gztproject/NixieClock/PCB/NixieClock2.png

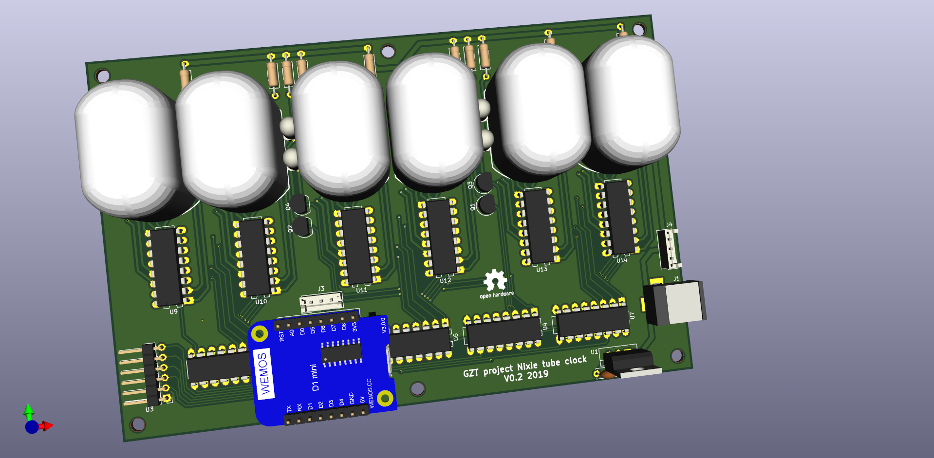
PCB/NixieClock2.png
