gztproject/NixieClock/README.md

# NixieClock

* Install VS Code
  * Install PlatformIO
* Clone/download this repo
* Open with VS Code/PlatformIO
* Copy config_override_example.h to config_override.h
  * Edit settings in config_override.h
* Build and upload to your ESP8266
