gztproject/NixieClock/PCB/NixieClock.png

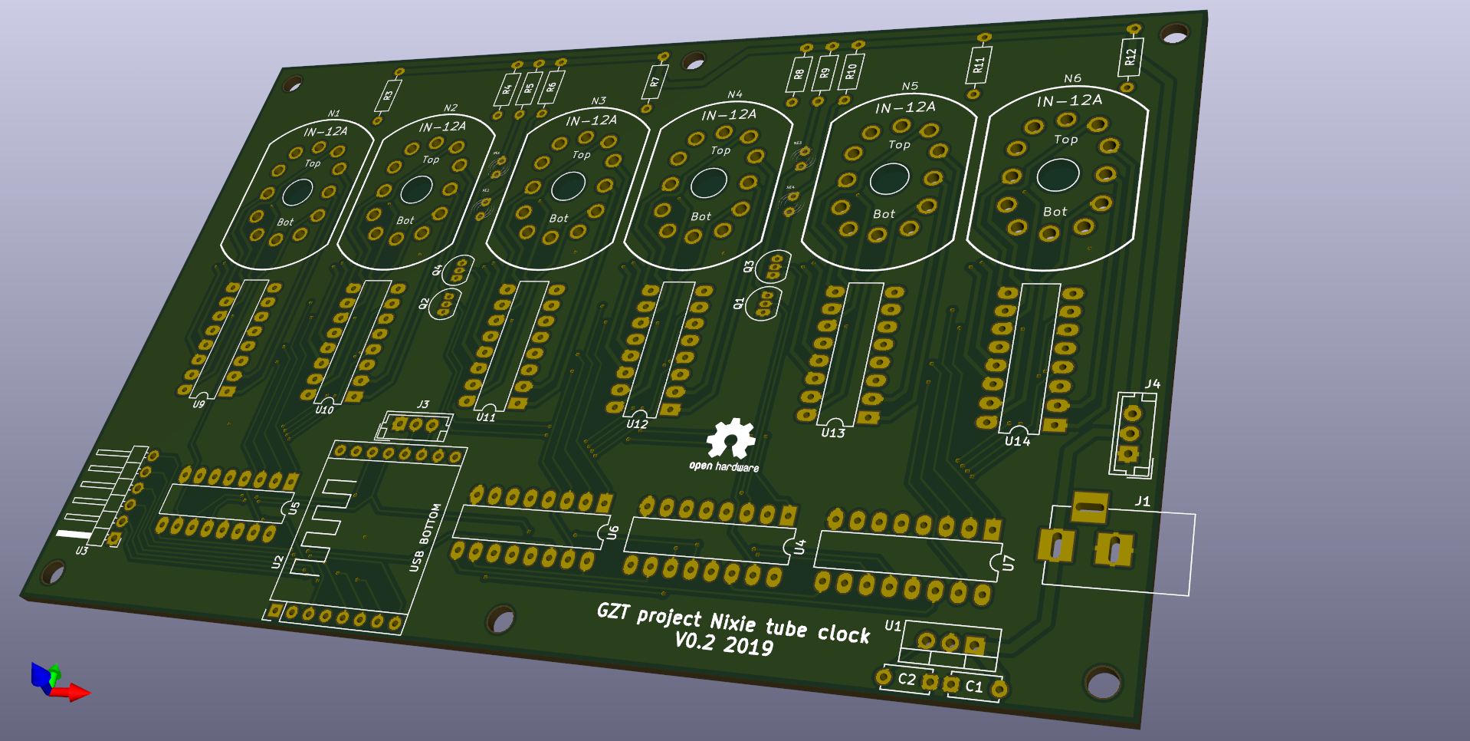
PCB/NixieClock.png
