gztproject/NixieClock/PCB/NixieClock.pdf

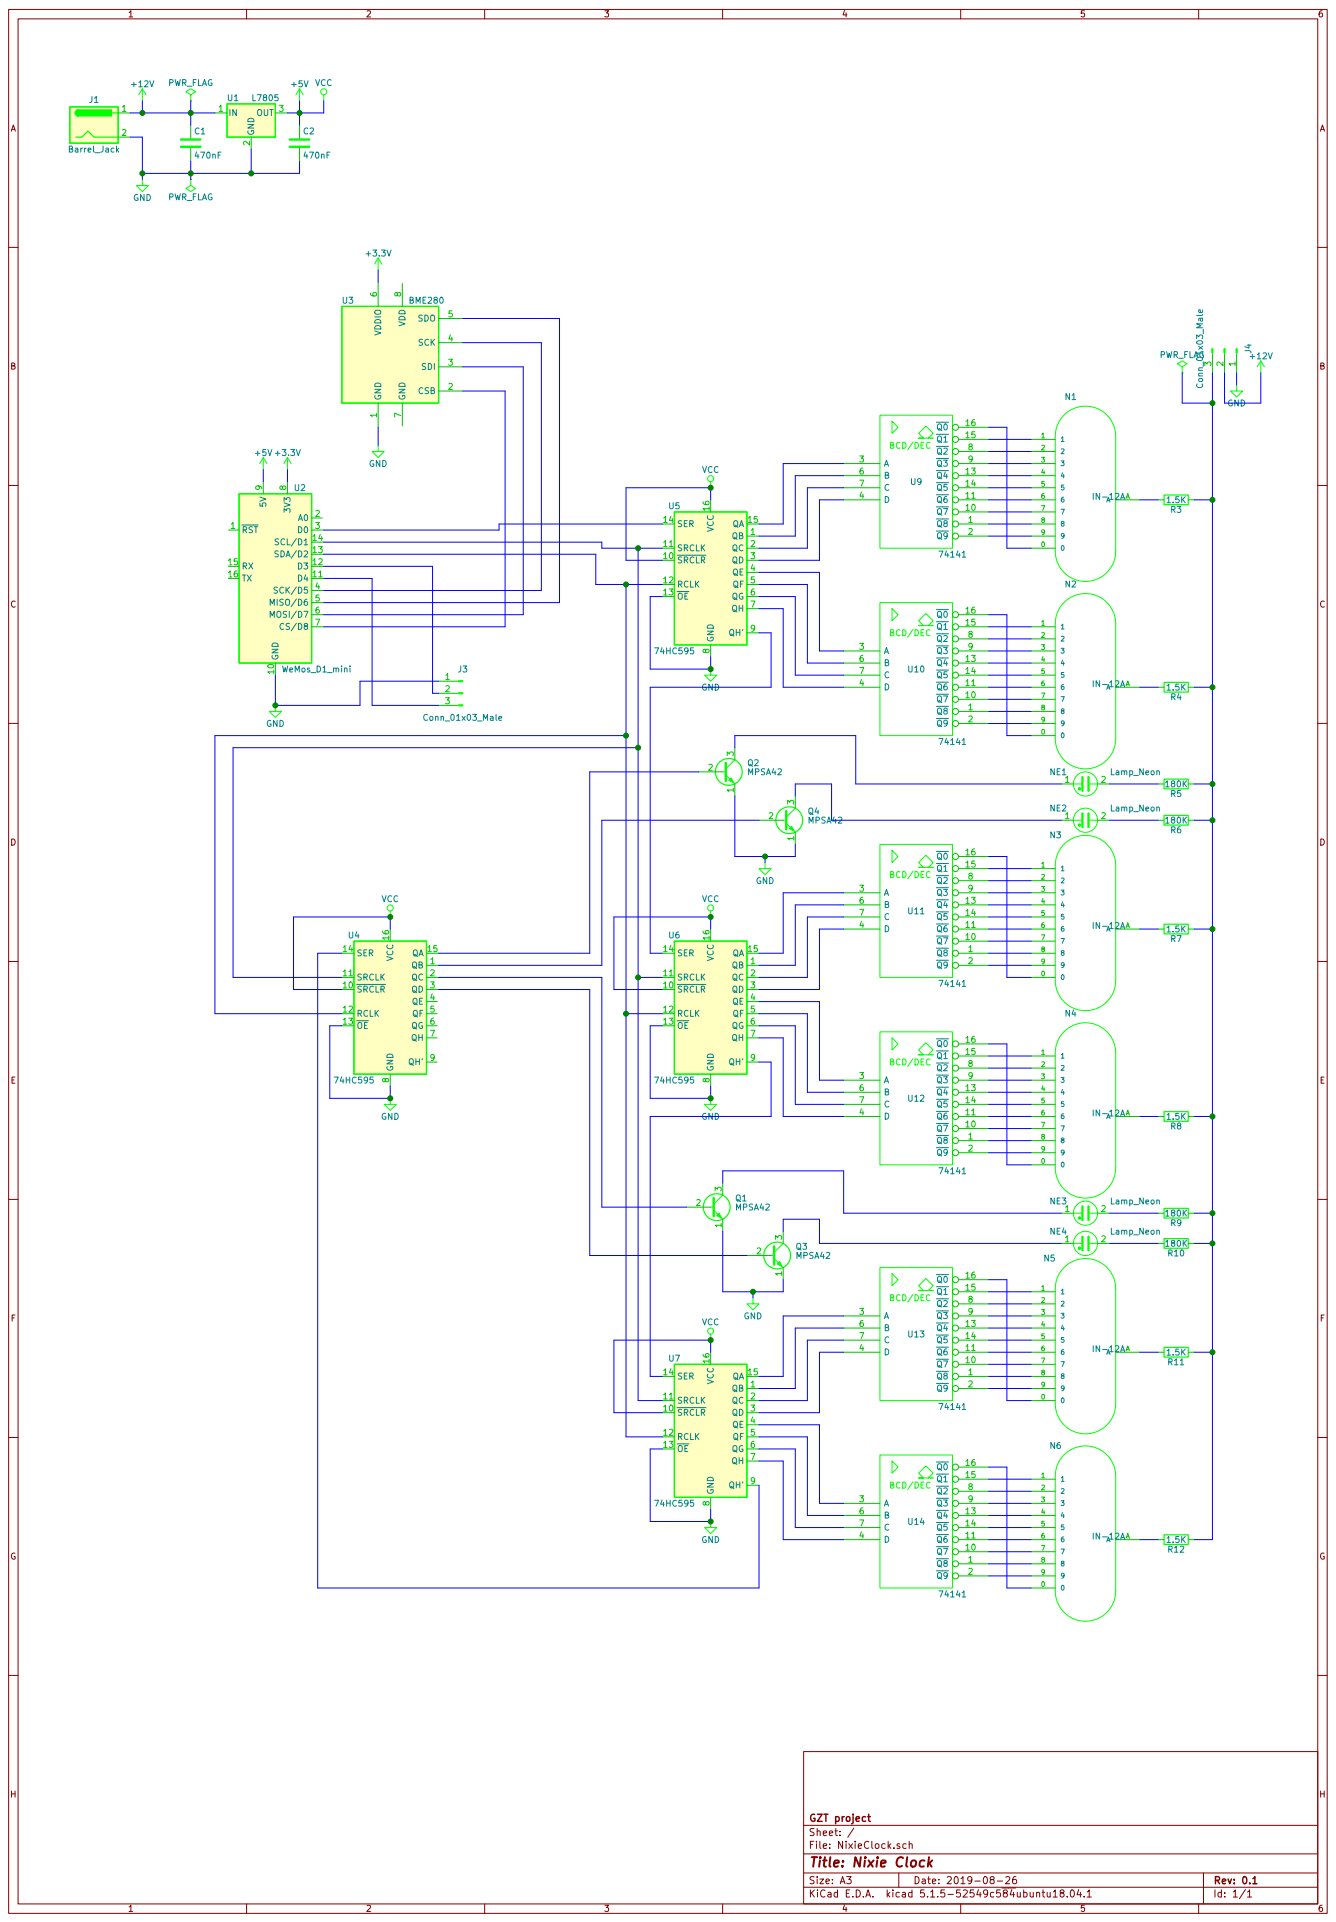
[picture p3: page 1]

1 CSB 2 SDI 3 SCK 4 SDO 5 VDDIO

3 Q2 MPSA42 VCC GND QB 1 SRCLR 10 SRCLK 11 RCLK 12 OE 13 SER 14 QA 15 VCC 16 QC 2 QD 3 QE 4 QF 5 QG 6 QH 7 GND

File: NixieClock.sch Sheet: / GZT project

Id: 1/1 Title: Nixie Clock
