gztproject/NixieClock/PCB/NixieClock.kicad_pcb

## KiCad design PCB/NixieClock.kicad_pcb (2022-11-04)

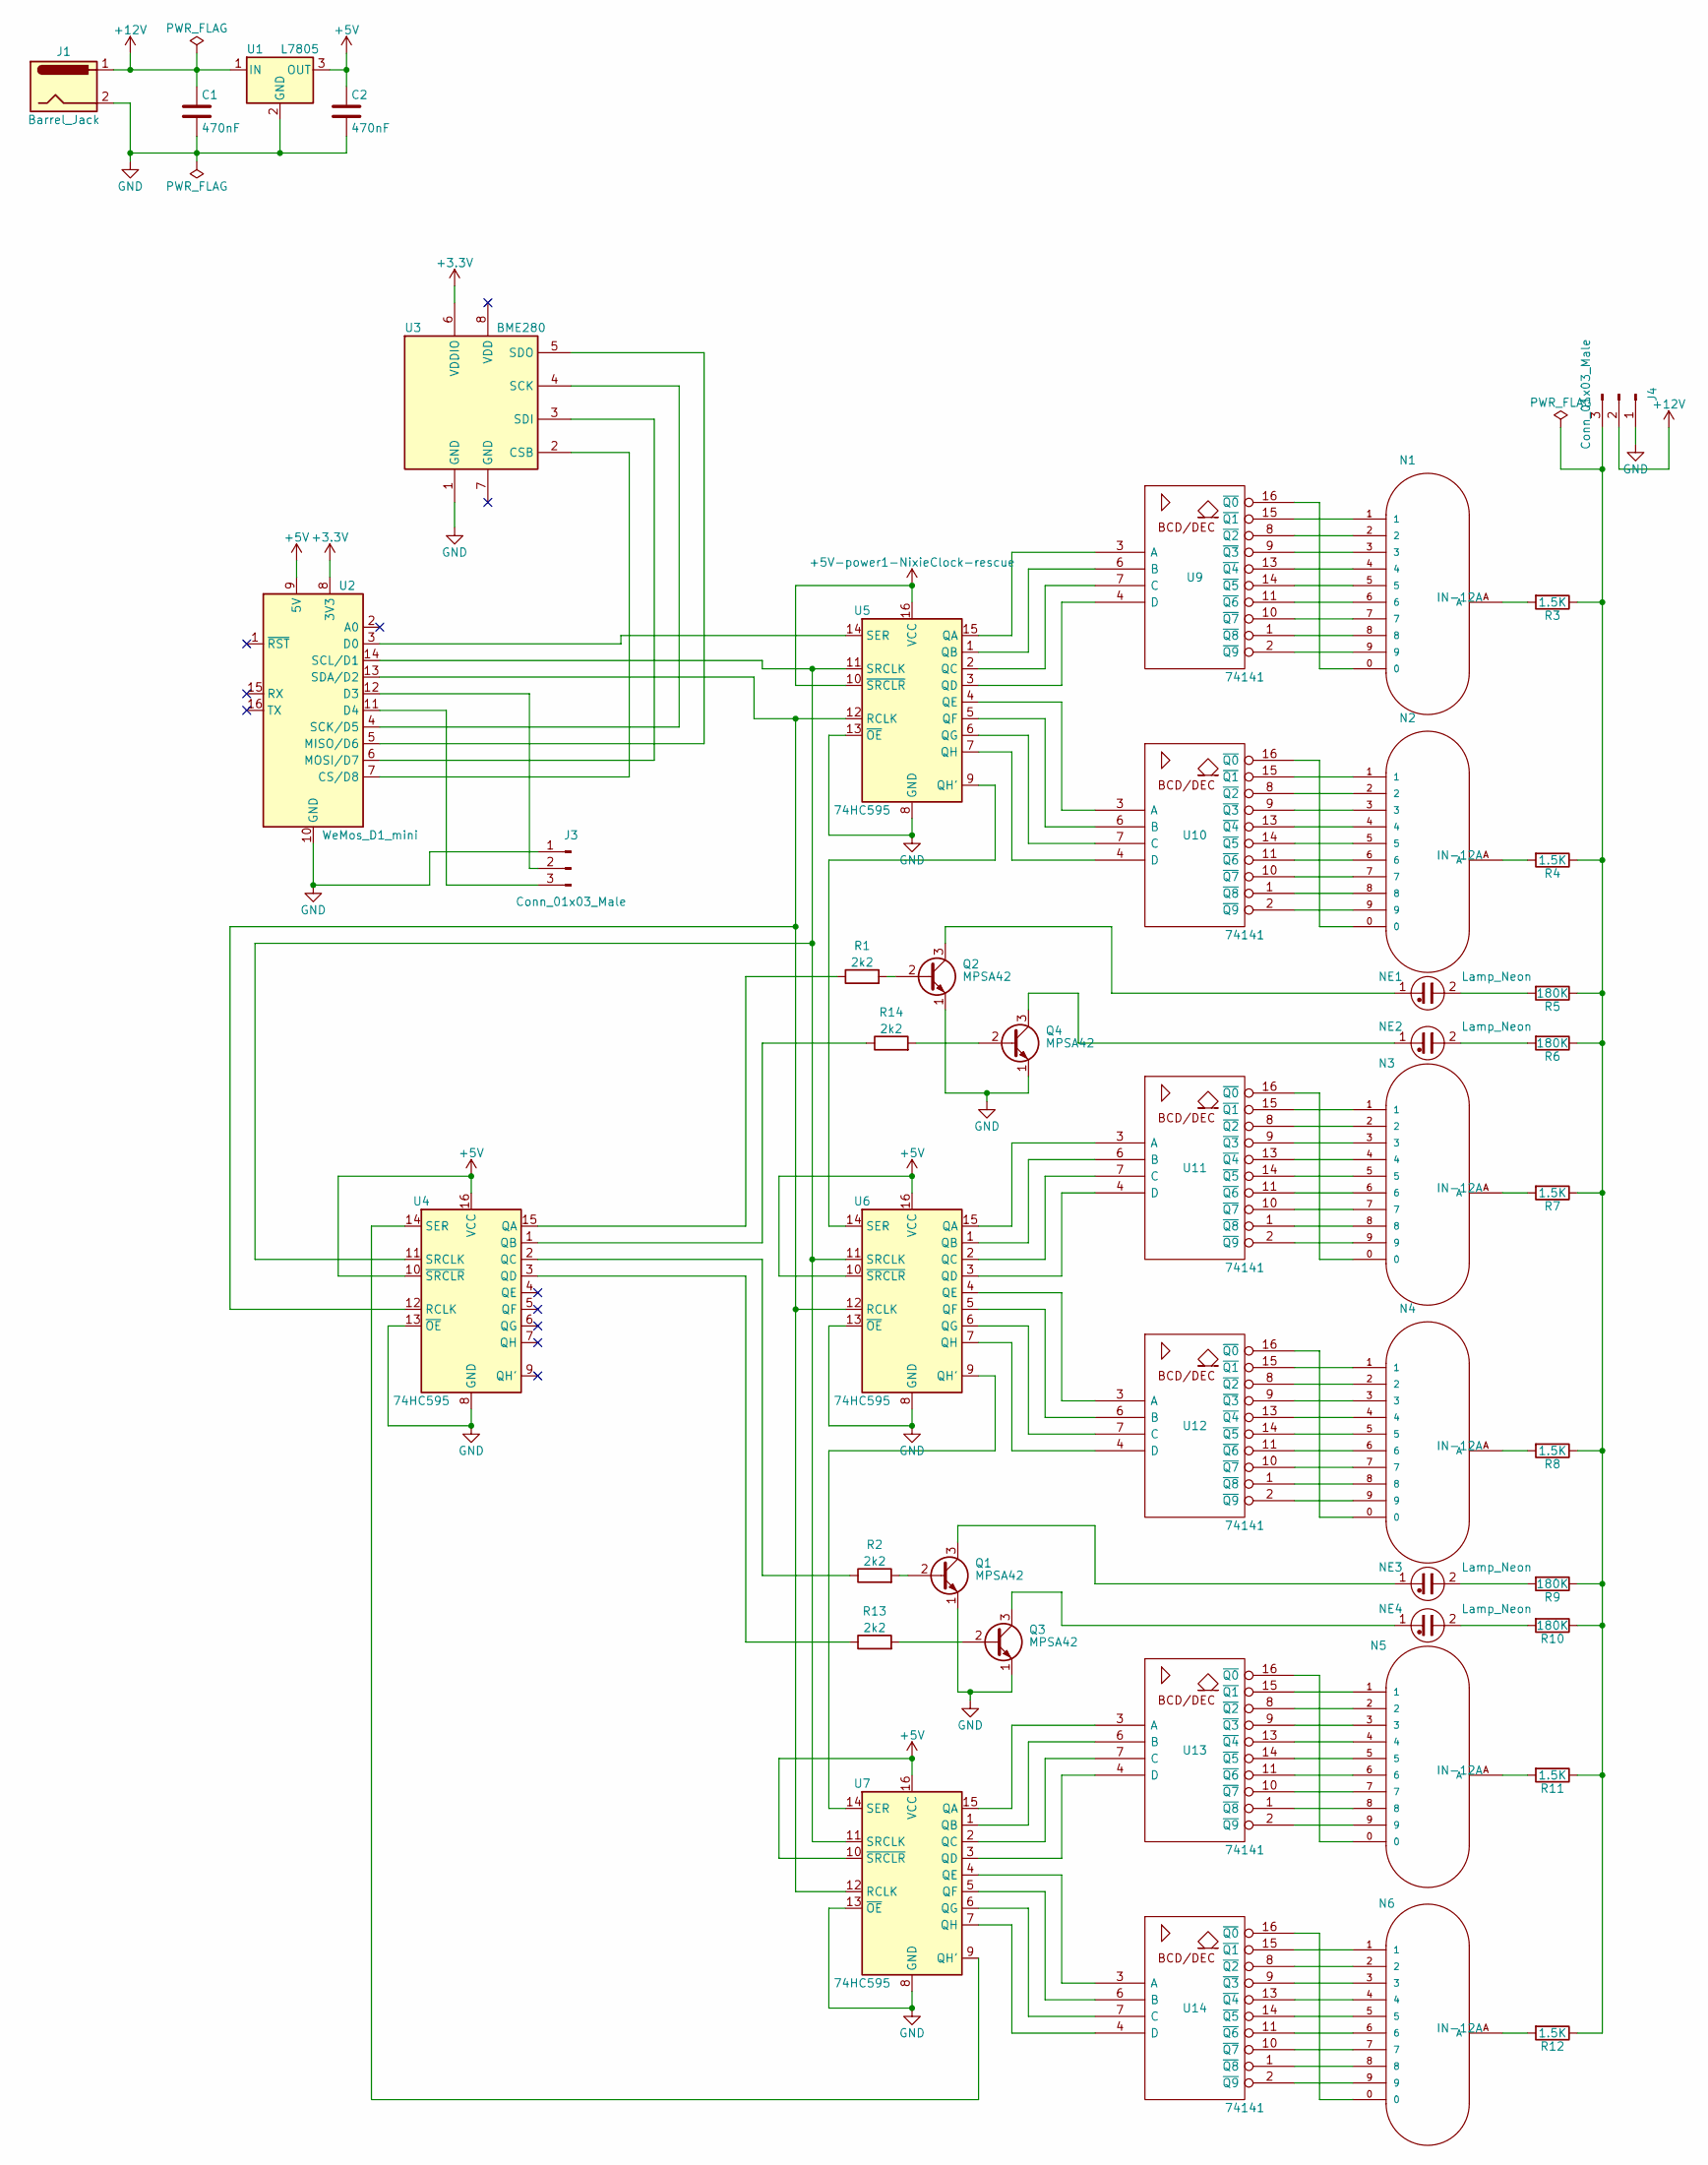
[picture p4: schematic NixieClock.kicad_sch, Nixie Clock]

Parts:
C1, C2: 470nF; C_Disc_D5.0mm_W2.5mm_P5.00mm
J1: Barrel_Jack; BARREL_JACK
J3, J4: Conn_01x03_Male; JST_EH_B03B-EH-A_03x2.50mm_Straight
N1, N2, N3, N4, N5, N6: IN-12A; IN-12-DSUB
NE1, NE2, NE3, NE4: Lamp_Neon; NE2-NEON-BULB-DRILL
Q1, Q2, Q3, Q4: MPSA42; TO-92_Inline_Narrow_Oval
R1, R2, R13, R14: 2k2; R_Axial_DIN0207_L6.3mm_D2.5mm_P10.16mm_Horizontal
R3, R4, R7, R8, R11, R12: 1.5K; R_Axial_DIN0207_L6.3mm_D2.5mm_P10.16mm_Horizontal
R5, R6, R9, R10: 180K; R_Axial_DIN0207_L6.3mm_D2.5mm_P10.16mm_Horizontal
U1: L7805; TO-220-3_Vertical
U2: WeMos_D1_mini; Pololu_Breakout-16_15.2x20.3mm
U3: BME280; PinHeader_1x06_P2.54mm_Horizontal
U4, U5, U6, U7: 74HC595; DIP-16_W7.62mm_LongPads
U9, U10, U11, U12, U13, U14: 74141; DIP-16_W7.62mm_LongPads

Connections:
+3V3: U2.8 (3V3), U3.6 (VDDIO)
+12V: C1.1, J1.1, J4.2, U1.1 (IN)
GND: C1.2, C2.2, J1.2, J3.1, J4.1, Q1.1 (E), Q2.1 (E), Q3.1 (E), Q4.1 (E), U1.2 (GND), U2.10 (GND), U3.1 (GND), U4.8 (GND), U4.13 (~OE), U5.8 (GND), U5.13 (~OE), U6.8 (GND), U6.13 (~OE), U7.8 (GND), U7.13 (~OE), U9.12 (GND), U10.12 (GND), U11.12 (GND), U12.12 (GND), U13.12 (GND), U14.12 (GND)
unnamed: J3.2, U2.12 (D3)
unnamed: J3.3, U2.11 (D4)
unnamed: J4.3, R3.1, R4.1, R5.1, R6.1, R7.1, R8.1, R9.1, R10.1, R11.1, R12.1
unnamed: N1.0, U9.16 (~Q0)
unnamed: N1.1, U9.15 (~Q1)
unnamed: N1.2, U9.8 (~Q2)
unnamed: N1.3, U9.9 (~Q3)
unnamed: N1.4, U9.13 (~Q4)
unnamed: N1.5, U9.14 (~Q5)
unnamed: N1.6, U9.11 (~Q6)
unnamed: N1.7, U9.10 (~Q7)
unnamed: N1.8, U9.1 (~Q8)
unnamed: N1.9, U9.2 (~Q9)
unnamed: N1.A, R3.2
unnamed: N2.0, U10.16 (~Q0)
unnamed: N2.1, U10.15 (~Q1)
unnamed: N2.2, U10.8 (~Q2)
unnamed: N2.3, U10.9 (~Q3)
unnamed: N2.4, U10.13 (~Q4)
unnamed: N2.5, U10.14 (~Q5)
unnamed: N2.6, U10.11 (~Q6)
unnamed: N2.7, U10.10 (~Q7)
unnamed: N2.8, U10.1 (~Q8)
unnamed: N2.9, U10.2 (~Q9)
unnamed: N2.A, R4.2
unnamed: N3.0, U11.16 (~Q0)
unnamed: N3.1, U11.15 (~Q1)
unnamed: N3.2, U11.8 (~Q2)
unnamed: N3.3, U11.9 (~Q3)
unnamed: N3.4, U11.13 (~Q4)
unnamed: N3.5, U11.14 (~Q5)
unnamed: N3.6, U11.11 (~Q6)
unnamed: N3.7, U11.10 (~Q7)
unnamed: N3.8, U11.1 (~Q8)
unnamed: N3.9, U11.2 (~Q9)
unnamed: N3.A, R7.2
unnamed: N4.0, U12.16 (~Q0)
unnamed: N4.1, U12.15 (~Q1)
unnamed: N4.2, U12.8 (~Q2)
unnamed: N4.3, U12.9 (~Q3)
unnamed: N4.4, U12.13 (~Q4)
unnamed: N4.5, U12.14 (~Q5)
unnamed: N4.6, U12.11 (~Q6)
unnamed: N4.7, U12.10 (~Q7)
unnamed: N4.8, U12.1 (~Q8)
unnamed: N4.9, U12.2 (~Q9)
unnamed: N4.A, R8.2
unnamed: N5.0, U13.16 (~Q0)
unnamed: N5.1, U13.15 (~Q1)
unnamed: N5.2, U13.8 (~Q2)
unnamed: N5.3, U13.9 (~Q3)
unnamed: N5.4, U13.13 (~Q4)
unnamed: N5.5, U13.14 (~Q5)
unnamed: N5.6, U13.11 (~Q6)
unnamed: N5.7, U13.10 (~Q7)
unnamed: N5.8, U13.1 (~Q8)
unnamed: N5.9, U13.2 (~Q9)
unnamed: N5.A, R11.2
unnamed: N6.0, U14.16 (~Q0)
unnamed: N6.1, U14.15 (~Q1)
unnamed: N6.2, U14.8 (~Q2)
unnamed: N6.3, U14.9 (~Q3)
unnamed: N6.4, U14.13 (~Q4)
unnamed: N6.5, U14.14 (~Q5)
unnamed: N6.6, U14.11 (~Q6)
unnamed: N6.7, U14.10 (~Q7)
unnamed: N6.8, U14.1 (~Q8)
unnamed: N6.9, U14.2 (~Q9)
unnamed: N6.A, R12.2
unnamed: NE1.1, Q2.3 (C)
unnamed: NE1.2, R5.2
unnamed: NE2.1, Q4.3 (C)
unnamed: NE2.2, R6.2
unnamed: NE3.1, Q1.3 (C)
unnamed: NE3.2, R9.2
unnamed: NE4.1, Q3.3 (C)
unnamed: NE4.2, R10.2
unnamed: Q1.2 (B), R2.2
unnamed: Q2.2 (B), R1.2
unnamed: Q3.2 (B), R13.2
unnamed: Q4.2 (B), R14.2
unnamed: U2.3 (D0), U5.14 (SER)
unnamed: U2.4 (SCK/D5), U3.4 (SCK)
unnamed: U2.5 (MISO/D6), U3.5 (SDO)
unnamed: U2.6 (MOSI/D7), U3.3 (SDI)
unnamed: U2.7 (CS/D8), U3.2 (CSB)
unnamed: U2.13 (SDA/D2), U4.12 (RCLK), U5.12 (RCLK), U6.12 (RCLK), U7.12 (RCLK)
unnamed: U2.14 (SCL/D1), U4.11 (SRCLK), U5.11 (SRCLK), U6.11 (SRCLK), U7.11 (SRCLK)
unnamed: R14.1, U4.1 (QB)
unnamed: R2.1, U4.2 (QC)
unnamed: R13.1, U4.3 (QD)
unnamed: U4.14 (SER), U7.9 (QH')
unnamed: R1.1, U4.15 (QA)
unnamed: U5.1 (QB), U9.6 (B)
unnamed: U5.2 (QC), U9.7 (C)
unnamed: U5.3 (QD), U9.4 (D)
unnamed: U5.9 (QH'), U6.14 (SER)
unnamed: U5.15 (QA), U9.3 (A)
unnamed: U6.9 (QH'), U7.14 (SER)
unnamed: U5.4 (QE), U10.3 (A)
unnamed: U5.7 (QH), U10.4 (D)
unnamed: U5.5 (QF), U10.6 (B)
unnamed: U5.6 (QG), U10.7 (C)
unnamed: U6.15 (QA), U11.3 (A)
unnamed: U6.3 (QD), U11.4 (D)
unnamed: U6.1 (QB), U11.6 (B)
unnamed: U6.2 (QC), U11.7 (C)
unnamed: U6.4 (QE), U12.3 (A)
unnamed: U6.7 (QH), U12.4 (D)
unnamed: U6.5 (QF), U12.6 (B)
unnamed: U6.6 (QG), U12.7 (C)
unnamed: U7.15 (QA), U13.3 (A)
unnamed: U7.3 (QD), U13.4 (D)
unnamed: U7.1 (QB), U13.6 (B)
unnamed: U7.2 (QC), U13.7 (C)
unnamed: U7.4 (QE), U14.3 (A)
unnamed: U7.7 (QH), U14.4 (D)
unnamed: U7.5 (QF), U14.6 (B)
unnamed: U7.6 (QG), U14.7 (C)

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
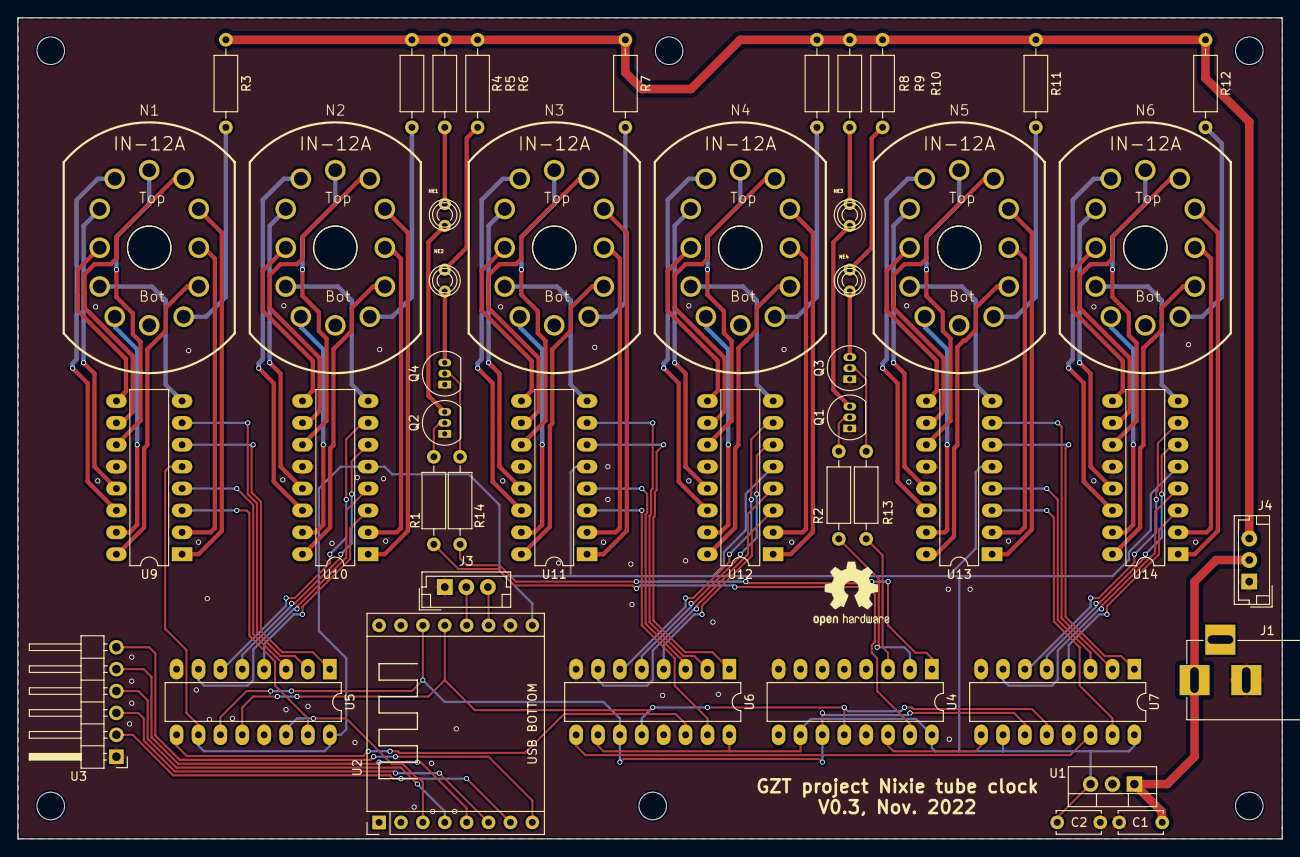
[picture p5: board NixieClock.kicad_pcb from above]

Board: 2 copper layers, 146.7 x 95.2 mm, 46 parts (0 on the bottom side), 123 nets.
