gztproject/NixieClock/(threads)

Thread 1 (2020-09-08):

Build errors from platformio

mr-sneezy, 2020-09-08:
I've had some PCB's made by JLCPCB and am now trying to build the code for a D1 Mini.

Got a lot of PlatformIO build errors, more that my very limited Arduino experience can cope with. Looks like I'm doing something wrong, anyone got an idea on how to clear some of these?
The first is this error: 'localtime' was not declared in this scope in the NTP.cpp

Processing d1_mini (platform: espressif8266; board: d1_mini; framework: arduino)
-----------------------------------------------------------------------------------------------------------------------------------------------------------------------------------

Verbose mode can be enabled via `-v, --verbose` option
CONFIGURATION: https://docs.platformio.org/page/boards/espressif8266/d1_mini.html
PLATFORM: Espressif 8266 (1.6.0) > WeMos D1 R2 & mini
HARDWARE: ESP8266 80MHz, 80KB RAM, 4MB Flash
PACKAGES:
 - framework-arduinoespressif8266 1.20400.1 (2.4.0)
 - tool-esptool 1.409.0 (4.9)
 - toolchain-xtensa 1.40802.0 (4.8.2)
LDF: Library Dependency Finder -> http://bit.ly/configure-pio-ldf
LDF Modes: Finder ~ chain, Compatibility ~ soft
Found 31 compatible libraries
Scanning dependencies...
Dependency Graph
|-- <ShiftRegister74HC595> 1.3.1
|-- <MyWiFi>
|   |-- <ESP8266WiFi> 1.0
|-- <NixieClock>
|   |-- <ShiftRegister74HC595> 1.3.1
|-- <NTP>
|   |-- <ESP8266WiFi> 1.0
|-- <OTA>
|   |-- <ArduinoOTA> 1.0
|   |   |-- <ESP8266WiFi> 1.0
|   |   |-- <ESP8266mDNS>
|   |   |   |-- <ESP8266WiFi> 1.0
Building in release mode
Compiling .pio\build\d1_mini\lib9c0\NTP\NTP.cpp.o
Compiling .pio\build\d1_mini\FrameworkArduino\Print.cpp.o
Compiling .pio\build\d1_mini\FrameworkArduino\Schedule.cpp.o
Compiling .pio\build\d1_mini\FrameworkArduino\Stream.cpp.o
Compiling .pio\build\d1_mini\FrameworkArduino\StreamString.cpp.o
lib\NTP\src\NTP.cpp: In member function 'void NTP::CheckTime()':
lib\NTP\src\NTP.cpp:88:37: error: 'localtime' was not declared in this scope
     timeinfo = localtime (&localTime);
                                     ^
lib\NTP\src\NTP.cpp: In member function 'int NTP::getSeconds()':
lib\NTP\src\NTP.cpp:151:20: error: invalid use of incomplete type 'struct tm'
     return timeinfo->tm_sec;
                    ^
In file included from c:\users\martin\.platformio\packages\toolchain-xtensa\xtensa-lx106-elf\include\c++\4.8.2\cwchar:44:0,
                 from c:\users\martin\.platformio\packages\toolchain-xtensa\xtensa-lx106-elf\include\c++\4.8.2\bits\postypes.h:40,
                 from c:\users\martin\.platformio\packages\toolchain-xtensa\xtensa-lx106-elf\include\c++\4.8.2\bits\char_traits.h:40,
                 from c:\users\martin\.platformio\packages\toolchain-xtensa\xtensa-lx106-elf\include\c++\4.8.2\string:40,
                 from c:\users\martin\.platformio\packages\toolchain-xtensa\xtensa-lx106-elf\include\c++\4.8.2\random:41,
                 from c:\users\martin\.platformio\packages\toolchain-xtensa\xtensa-lx106-elf\include\c++\4.8.2\bits\stl_algo.h:65,
                 from c:\users\martin\.platformio\packages\toolchain-xtensa\xtensa-lx106-elf\include\c++\4.8.2\algorithm:62,
                 from C:\Users\Martin\.platformio\packages\framework-arduinoespressif8266\cores\esp8266/Arduino.h:240,
                 from lib\NTP\src/NTP.h:6,
                 from lib\NTP\src\NTP.cpp:2:
C:\Users\Martin\.platformio\packages\framework-arduinoespressif8266\tools\sdk\libc\xtensa-lx106-elf\include/wchar.h:56:8: error: forward declaration of 'struct tm'
 struct tm;
        ^
lib\NTP\src\NTP.cpp: In member function 'int NTP::getMinutes()':
lib\NTP\src\NTP.cpp:155:20: error: invalid use of incomplete type 'struct tm'
     return timeinfo->tm_min;
                    ^
In file included from c:\users\martin\.platformio\packages\toolchain-xtensa\xtensa-lx106-elf\include\c++\4.8.2\cwchar:44:0,
                 from c:\users\martin\.platformio\packages\toolchain-xtensa\xtensa-lx106-elf\include\c++\4.8.2\bits\postypes.h:40,
Compiling .pio\build\d1_mini\FrameworkArduino\Tone.cpp.o
                 from c:\users\martin\.platformio\packages\toolchain-xtensa\xtensa-lx106-elf\include\c++\4.8.2\bits\char_traits.h:40,
Compiling .pio\build\d1_mini\FrameworkArduino\Updater.cpp.o
                 from c:\users\martin\.platformio\packages\toolchain-xtensa\xtensa-lx106-elf\include\c++\4.8.2\string:40,
                 from c:\users\martin\.platformio\packages\toolchain-xtensa\xtensa-lx106-elf\include\c++\4.8.2\random:41,
                 from c:\users\martin\.platformio\packages\toolchain-xtensa\xtensa-lx106-elf\include\c++\4.8.2\bits\stl_algo.h:65,
                 from c:\users\martin\.platformio\packages\toolchain-xtensa\xtensa-lx106-elf\include\c++\4.8.2\algorithm:62,
                 from C:\Users\Martin\.platformio\packages\framework-arduinoespressif8266\cores\esp8266/Arduino.h:240,
                 from lib\NTP\src/NTP.h:6,
                 from lib\NTP\src\NTP.cpp:2:
C:\Users\Martin\.platformio\packages\framework-arduinoespressif8266\tools\sdk\libc\xtensa-lx106-elf\include/wchar.h:56:8: error: forward declaration of 'struct tm'
 struct tm;
        ^
lib\NTP\src\NTP.cpp: In member function 'int NTP::getHours()':
lib\NTP\src\NTP.cpp:159:20: error: invalid use of incomplete type 'struct tm'
     return timeinfo->tm_hour;
                    ^
In file included from c:\users\martin\.platformio\packages\toolchain-xtensa\xtensa-lx106-elf\include\c++\4.8.2\cwchar:44:0,
                 from c:\users\martin\.platformio\packages\toolchain-xtensa\xtensa-lx106-elf\include\c++\4.8.2\bits\postypes.h:40,
                 from c:\users\martin\.platformio\packages\toolchain-xtensa\xtensa-lx106-elf\include\c++\4.8.2\bits\char_traits.h:40,
                 from c:\users\martin\.platformio\packages\toolchain-xtensa\xtensa-lx106-elf\include\c++\4.8.2\string:40,
                 from c:\users\martin\.platformio\packages\toolchain-xtensa\xtensa-lx106-elf\include\c++\4.8.2\random:41,
                 from c:\users\martin\.platformio\packages\toolchain-xtensa\xtensa-lx106-elf\include\c++\4.8.2\bits\stl_algo.h:65,
                 from c:\users\martin\.platformio\packages\toolchain-xtensa\xtensa-lx106-elf\include\c++\4.8.2\algorithm:62,
                 from C:\Users\Martin\.platformio\packages\framework-arduinoespressif8266\cores\esp8266/Arduino.h:240,
                 from lib\NTP\src/NTP.h:6,
                 from lib\NTP\src\NTP.cpp:2:
C:\Users\Martin\.platformio\packages\framework-arduinoespressif8266\tools\sdk\libc\xtensa-lx106-elf\include/wchar.h:56:8: error: forward declaration of 'struct tm'
 struct tm;
        ^
lib\NTP\src\NTP.cpp: In member function 'int NTP::getDay()':
lib\NTP\src\NTP.cpp:163:20: error: invalid use of incomplete type 'struct tm'
     return timeinfo->tm_mday;
Compiling .pio\build\d1_mini\FrameworkArduino\WMath.cpp.o
                    ^
In file included from c:\users\martin\.platformio\packages\toolchain-xtensa\xtensa-lx106-elf\include\c++\4.8.2\cwchar:44:0,
                 from c:\users\martin\.platformio\packages\toolchain-xtensa\xtensa-lx106-elf\include\c++\4.8.2\bits\postypes.h:40,
                 from c:\users\martin\.platformio\packages\toolchain-xtensa\xtensa-lx106-elf\include\c++\4.8.2\bits\char_traits.h:40,
                 from c:\users\martin\.platformio\packages\toolchain-xtensa\xtensa-lx106-elf\include\c++\4.8.2\string:40,
                 from c:\users\martin\.platformio\packages\toolchain-xtensa\xtensa-lx106-elf\include\c++\4.8.2\random:41,
                 from c:\users\martin\.platformio\packages\toolchain-xtensa\xtensa-lx106-elf\include\c++\4.8.2\bits\stl_algo.h:65,
                 from c:\users\martin\.platformio\packages\toolchain-xtensa\xtensa-lx106-elf\include\c++\4.8.2\algorithm:62,
                 from C:\Users\Martin\.platformio\packages\framework-arduinoespressif8266\cores\esp8266/Arduino.h:240,
                 from lib\NTP\src/NTP.h:6,
                 from lib\NTP\src\NTP.cpp:2:
C:\Users\Martin\.platformio\packages\framework-arduinoespressif8266\tools\sdk\libc\xtensa-lx106-elf\include/wchar.h:56:8: error: forward declaration of 'struct tm'
 struct tm;
        ^
lib\NTP\src\NTP.cpp: In member function 'int NTP::getDow()':
lib\NTP\src\NTP.cpp:167:20: error: invalid use of incomplete type 'struct tm'
     return timeinfo->tm_wday + 1;
                    ^
In file included from c:\users\martin\.platformio\packages\toolchain-xtensa\xtensa-lx106-elf\include\c++\4.8.2\cwchar:44:0,
                 from c:\users\martin\.platformio\packages\toolchain-xtensa\xtensa-lx106-elf\include\c++\4.8.2\bits\postypes.h:40,
                 from c:\users\martin\.platformio\packages\toolchain-xtensa\xtensa-lx106-elf\include\c++\4.8.2\bits\char_traits.h:40,
                 from c:\users\martin\.platformio\packages\toolchain-xtensa\xtensa-lx106-elf\include\c++\4.8.2\string:40,
                 from c:\users\martin\.platformio\packages\toolchain-xtensa\xtensa-lx106-elf\include\c++\4.8.2\random:41,
                 from c:\users\martin\.platformio\packages\toolchain-xtensa\xtensa-lx106-elf\include\c++\4.8.2\bits\stl_algo.h:65,
                 from c:\users\martin\.platformio\packages\toolchain-xtensa\xtensa-lx106-elf\include\c++\4.8.2\algorithm:62,
                 from C:\Users\Martin\.platformio\packages\framework-arduinoespressif8266\cores\esp8266/Arduino.h:240,
                 from lib\NTP\src/NTP.h:6,
                 from lib\NTP\src\NTP.cpp:2:
C:\Users\Martin\.platformio\packages\framework-arduinoespressif8266\tools\sdk\libc\xtensa-lx106-elf\include/wchar.h:56:8: error: forward declaration of 'struct tm'
 struct tm;
        ^
lib\NTP\src\NTP.cpp: In member function 'int NTP::getMonth()':
lib\NTP\src\NTP.cpp:171:20: error: invalid use of incomplete type 'struct tm'
     return timeinfo->tm_mon + 1;
                    ^
In file included from c:\users\martin\.platformio\packages\toolchain-xtensa\xtensa-lx106-elf\include\c++\4.8.2\cwchar:44:0,
                 from c:\users\martin\.platformio\packages\toolchain-xtensa\xtensa-lx106-elf\include\c++\4.8.2\bits\postypes.h:40,
                 from c:\users\martin\.platformio\packages\toolchain-xtensa\xtensa-lx106-elf\include\c++\4.8.2\bits\char_traits.h:40,
                 from c:\users\martin\.platformio\packages\toolchain-xtensa\xtensa-lx106-elf\include\c++\4.8.2\string:40,
                 from c:\users\martin\.platformio\packages\toolchain-xtensa\xtensa-lx106-elf\include\c++\4.8.2\random:41,
                 from c:\users\martin\.platformio\packages\toolchain-xtensa\xtensa-lx106-elf\include\c++\4.8.2\bits\stl_algo.h:65,
                 from c:\users\martin\.platformio\packages\toolchain-xtensa\xtensa-lx106-elf\include\c++\4.8.2\algorithm:62,
                 from C:\Users\Martin\.platformio\packages\framework-arduinoespressif8266\cores\esp8266/Arduino.h:240,
                 from lib\NTP\src/NTP.h:6,
                 from lib\NTP\src\NTP.cpp:2:
C:\Users\Martin\.platformio\packages\framework-arduinoespressif8266\tools\sdk\libc\xtensa-lx106-elf\include/wchar.h:56:8: error: forward declaration of 'struct tm'
 struct tm;
        ^
lib\NTP\src\NTP.cpp: In member function 'int NTP::getYear()':
lib\NTP\src\NTP.cpp:175:20: error: invalid use of incomplete type 'struct tm'
     return timeinfo->tm_year + NTP_START_YEAR;
                    ^
In file included from c:\users\martin\.platformio\packages\toolchain-xtensa\xtensa-lx106-elf\include\c++\4.8.2\cwchar:44:0,
                 from c:\users\martin\.platformio\packages\toolchain-xtensa\xtensa-lx106-elf\include\c++\4.8.2\bits\postypes.h:40,
                 from c:\users\martin\.platformio\packages\toolchain-xtensa\xtensa-lx106-elf\include\c++\4.8.2\bits\char_traits.h:40,
                 from c:\users\martin\.platformio\packages\toolchain-xtensa\xtensa-lx106-elf\include\c++\4.8.2\string:40,
                 from c:\users\martin\.platformio\packages\toolchain-xtensa\xtensa-lx106-elf\include\c++\4.8.2\random:41,
                 from c:\users\martin\.platformio\packages\toolchain-xtensa\xtensa-lx106-elf\include\c++\4.8.2\bits\stl_algo.h:65,
                 from c:\users\martin\.platformio\packages\toolchain-xtensa\xtensa-lx106-elf\include\c++\4.8.2\algorithm:62,
                 from C:\Users\Martin\.platformio\packages\framework-arduinoespressif8266\cores\esp8266/Arduino.h:240,
                 from lib\NTP\src/NTP.h:6,
                 from lib\NTP\src\NTP.cpp:2:
C:\Users\Martin\.platformio\packages\framework-arduinoespressif8266\tools\sdk\libc\xtensa-lx106-elf\include/wchar.h:56:8: error: forward declaration of 'struct tm'
 struct tm;
        ^
lib\NTP\src\NTP.cpp: In member function 'int NTP::getDST()':
lib\NTP\src\NTP.cpp:199:37: error: 'ctime' was not declared in this scope
         Serial.print(ctime(&dstStart));
                                     ^
lib\NTP\src\NTP.cpp: In member function 'time_t NTP::calcTime(dstRule*)':
lib\NTP\src\NTP.cpp:240:15: error: aggregate 'tm tm2' has incomplete type and cannot be defined
     struct tm tm2;
               ^
lib\NTP\src\NTP.cpp:261:20: error: 'mktime' was not declared in this scope
     t = mktime(&tm2);
                    ^
*** [.pio\build\d1_mini\lib9c0\NTP\NTP.cpp.o] Error 1
=========================================================================== [FAILED] Took 6.49 seconds ===========================================================================
The terminal process "C:\Users\Martin\.platformio\penv\Scripts\platformio.exe 'run'" terminated with exit code: 1.

Terminal will be reused by tasks, press any key to close it.

micooke, 2020-09-17:
@mr-sneezy - thats an error generated by the pio core (looks like its missing #include <ctime>), I think you might need to update your pio platforms etc.

I downloaded VS Code and pulled the Platform IO plugin fresh and it compiled successfully.

```
Processing d1_mini (platform: espressif8266; board: d1_mini; framework: arduino)
----------------------------------------------------------------------------------------------------------------------------Verbose mode can be enabled via `-v, --verbose` option
CONFIGURATION: https://docs.platformio.org/page/boards/espressif8266/d1_mini.html
PLATFORM: Espressif 8266 (2.6.2) > WeMos D1 R2 and mini
HARDWARE: ESP8266 80MHz, 80KB RAM, 4MB Flash
PACKAGES:
 - framework-arduinoespressif8266 3.20704.0 (2.7.4)
 - tool-esptool 1.413.0 (4.13)
 - tool-esptoolpy 1.20800.0 (2.8.0)
 - toolchain-xtensa 2.40802.200502 (4.8.2)
LDF: Library Dependency Finder -> http://bit.ly/configure-pio-ldf
LDF Modes: Finder ~ chain, Compatibility ~ soft
Found 34 compatible libraries
Scanning dependencies...
```

mr-sneezy, 2020-09-17:
Thanks micooke. Given the news you built successfully, I setup VS Code and PlatformIO on a Win10 laptop that had never had either on it before. I cloned the repo locally and built from that successfully, and uploaded to a D1 Mini as well. So a win there.

I then tried to refresh PlatformIO on the main Win10 PC, no change. Then I uninstalled both platformIO and VS Code, restarted the PC, reinstalled both, pulled the repo down locally to a new location. Did the build, and nope failed again, with same errors. Stumped by that, but at least I can build on the laptop...

gztproject, 2022-11-04:
Closing the issue as it isn't about the project.

Closed 2022-11-04.

Thread 2 (2021-04-09):

Excessive heating of shift register U4

mr-sneezy, 2021-04-09:
Issue:
After finally getting time to assemble my build of this project I find that chip U4 is running at over 60-70C after a minute or so.

Cause:
Design omission in U4 connection to the four MPSA42 bipolar transistors that control the neon decimal point indicators.

Solution:
Add series current limiting resistors (as is normal practice) to the U4 logic output to transistor base.

Implementation:
As I got five boards made already, the easiest fix is to remove the transistors and refit with the base leg in the air, and put a 1Kohm resistor in the board base leg hole, and connect in the air to the transistor base leg.
U4 now runs at normal safe temperature.
(A bipolar transistor base-emitter junction behaves like a forward biased diode, pulling the source down to around 0.6V, the U4 logic outputs were being dragged down and causing maximum chip drive current on the four used outputs.)

gztproject, 2022-11-04:
I'm not sure why I omitted the resistors in the first place, but this is definitely a big oversight. As mentioned this puts excessive strain on U4 and also on the 7805 regulator, U1. Not to talk about excessive power consumption...

Will fix the PCB files to include the resistors.

gztproject, 2022-11-04:
Fixed

Closed 2022-11-04.

Thread 3 (2023-11-30):

Not an issue - GZT board inside...

mr-sneezy, 2023-11-30:
Where one of your designed boards end up :)

Use the image in your 'readme' page if you want.

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
