gztproject/NixieClock/(commit log)

2020-01-31 Added PCB
    [NixieClock.csv, NixieClock.kicad_pcb, NixieClock.ods, NixieClock.sch]
2020-01-31 PCB top fill
    [NixieClock.kicad_pcb]
2020-02-06 Some PCB fixes
    [HV.sch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]
2020-03-13 Updated PCB files
    [HV-2020-02-06-08-23-34.sch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]
2020-03-22 Reduced update rate, added RNG to cycleTubes()
    [NixieClock.kicad_pcb]
2022-11-04 Fixed issue #2 - added base resistors, layout touch-ups
    [HV-2020-02-06-08-23-34.sch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]
2024-05-23 Small fixes, gitignore
    [HV.sch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]
